valeriolomonaco/ai-traffic-light/enclosure/previews/diffuser.png

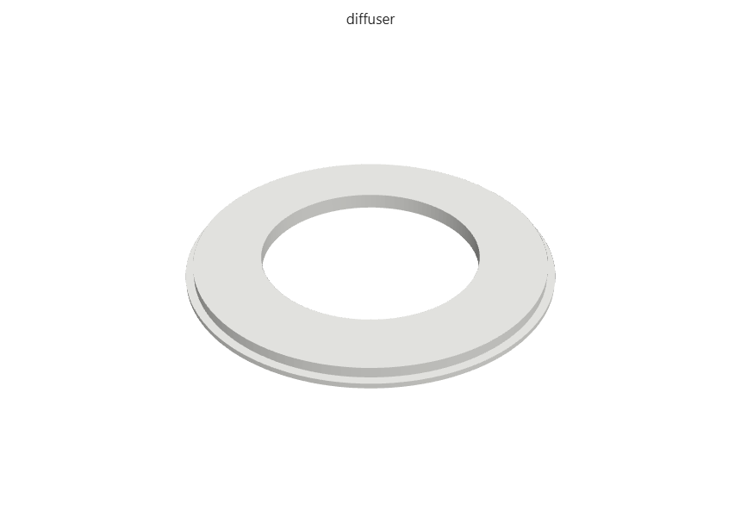
enclosure/previews/diffuser.png
