valeriolomonaco/ai-traffic-light/enclosure/previews/holder.png

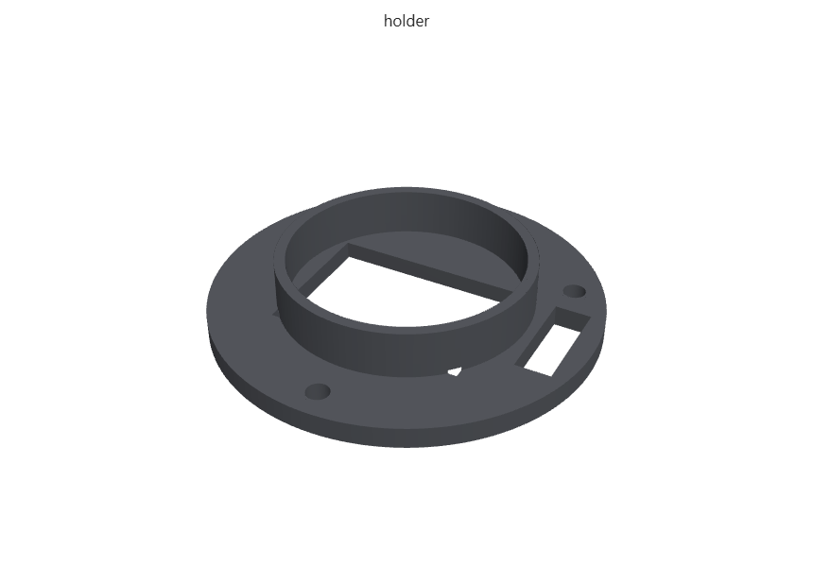
enclosure/previews/holder.png
