valeriolomonaco/ai-traffic-light/enclosure/previews/top.png

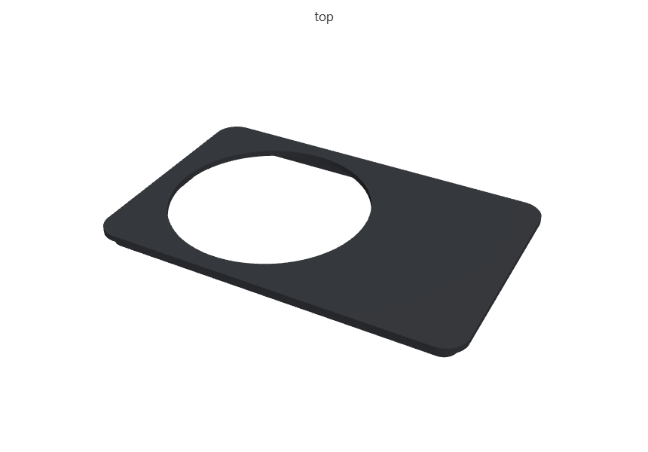
enclosure/previews/top.png
