valeriolomonaco/ai-traffic-light/enclosure/previews/tray.png

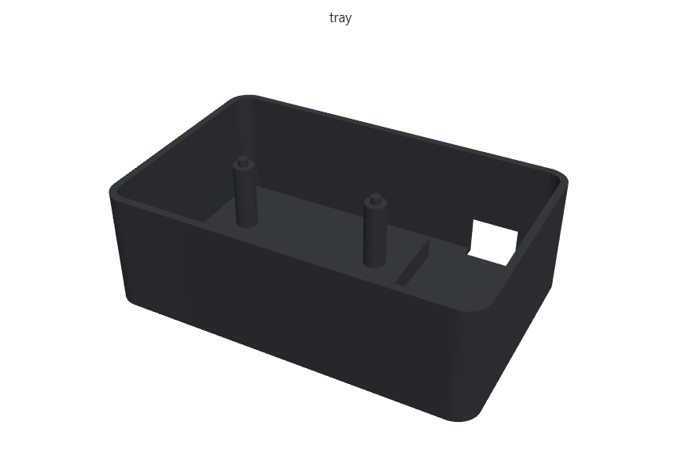
enclosure/previews/tray.png
