valeriolomonaco/ai-traffic-light/enclosure/stl/holder.stl

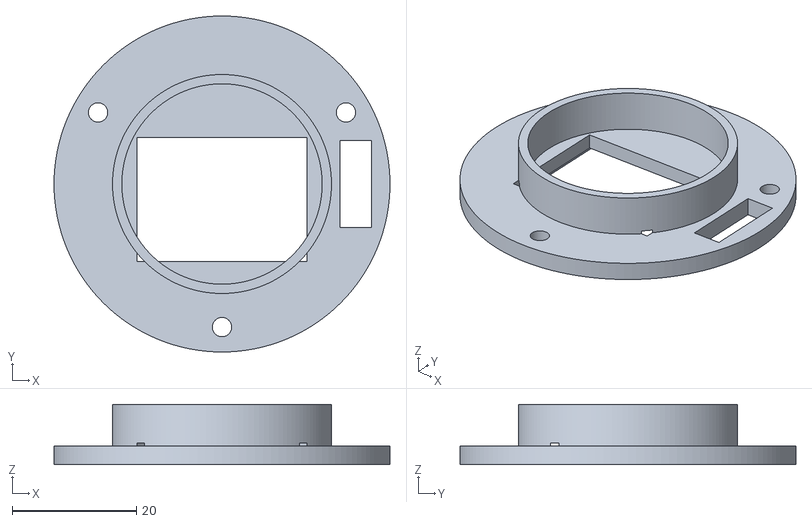
[picture p13: CAD file, 2026-10-27]
enclosure/stl/holder.stl
54.0 x 54.0 x 9.70
