valeriolomonaco/ai-traffic-light/enclosure/stl/diffuser.stl

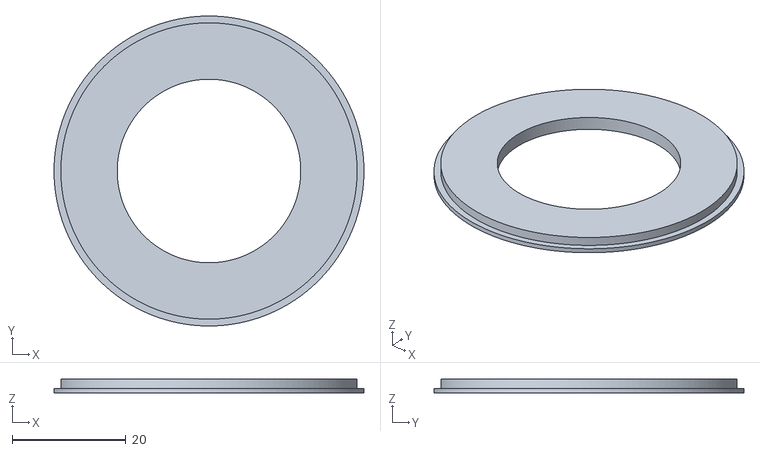
[picture p14: CAD file, 2026-10-27]
enclosure/stl/diffuser.stl
54.4 x 54.4 x 2.40
