valeriolomonaco/ai-traffic-light/enclosure/stl/tray.stl

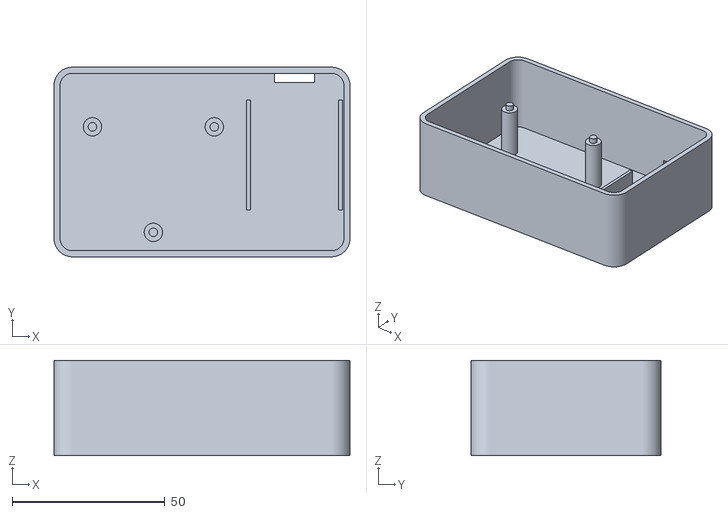
[picture p15: CAD file, 2026-10-27]
enclosure/stl/tray.stl
96.8 x 62.0 x 31.1
