valeriolomonaco/ai-traffic-light/enclosure/stl/top.stl

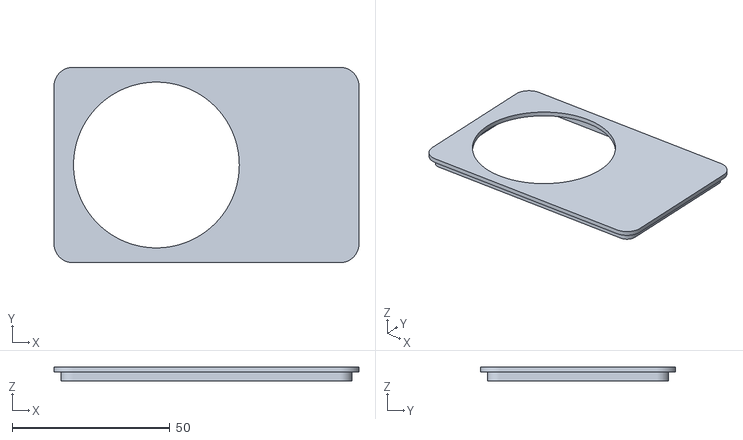
[picture p16: CAD file, 2026-10-27]
enclosure/stl/top.stl
96.8 x 62.0 x 4.60
