valeriolomonaco/ai-traffic-light/(commit log)

2026-10-27 Add blueprint, firmware, Wokwi simulation and Claude Code hook script
    - docs/BLUEPRINT.md: concept, parts list, wiring for Nano and ESP32,
    enclosure, timeline, MQTT roadmap, licensing notes
    - firmware/sketch/sketch.ino: one sketch for Nano and ESP32, LED ring
    plus SSD1306 OLED, serial protocol "G|Y|R|O <project>"
    - simulation/: ready Wokwi projects for both boards
    - host/: pyserial script called by Claude Code hooks, hooks example
2026-10-27 Add step-by-step build guide
    Parts list with checks before ordering, computer setup, staged
    assembly and tests, enclosure, prototype checklist, path to a final
    product, and troubleshooting. Linked from README and blueprint.
2026-10-27 Add part drawings, wiring diagram and Wokwi screenshots
    - docs/images: labelled drawings of each part, full wiring diagram
    and the four lamp states
    - docs/images/simulation: screenshots of the firmware running in
    Wokwi on ESP32 (every state) and Nano
    - Firmware: default ring brightness 80 -> 150 (clearer colours,
    still well within USB power)
    - Wokwi diagrams: parts placed beside the board, ESP32 ground pins
    matched to the wiring drawing
    - Simulation guide: libraries now added via Wokwi's Library Manager
2026-10-27 Compact flat-box design: ring of light framing the screen
    - enclosure/: parametric 3D-printable case (tray, holder, top, white
    diffuser), ready STL files, previews, and a collision check that
    places stand-ins for the ring, screen, board and plugs
    - Box is 97 x 62 x 33 mm; the screen sits behind the LED ring and is
    seen through its hole, the board lies beside it with pins up
    - Firmware: screen text centred so it sits in the ring's opening
    - Drawings: lamp states redrawn as the flat box, new labelled cut-through
    - Docs: blueprint, build guide and README updated for the printed case;
    ring must have a hole of 35 mm or more; caliper added to tools
    - Simulator screenshots refreshed with th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
2026-10-27 Correct the case plastic weight to 40-50 g and add the total lamp weight
